fedebarrilete/stm32f103_ds18b20_modbus/eschematic.pdf

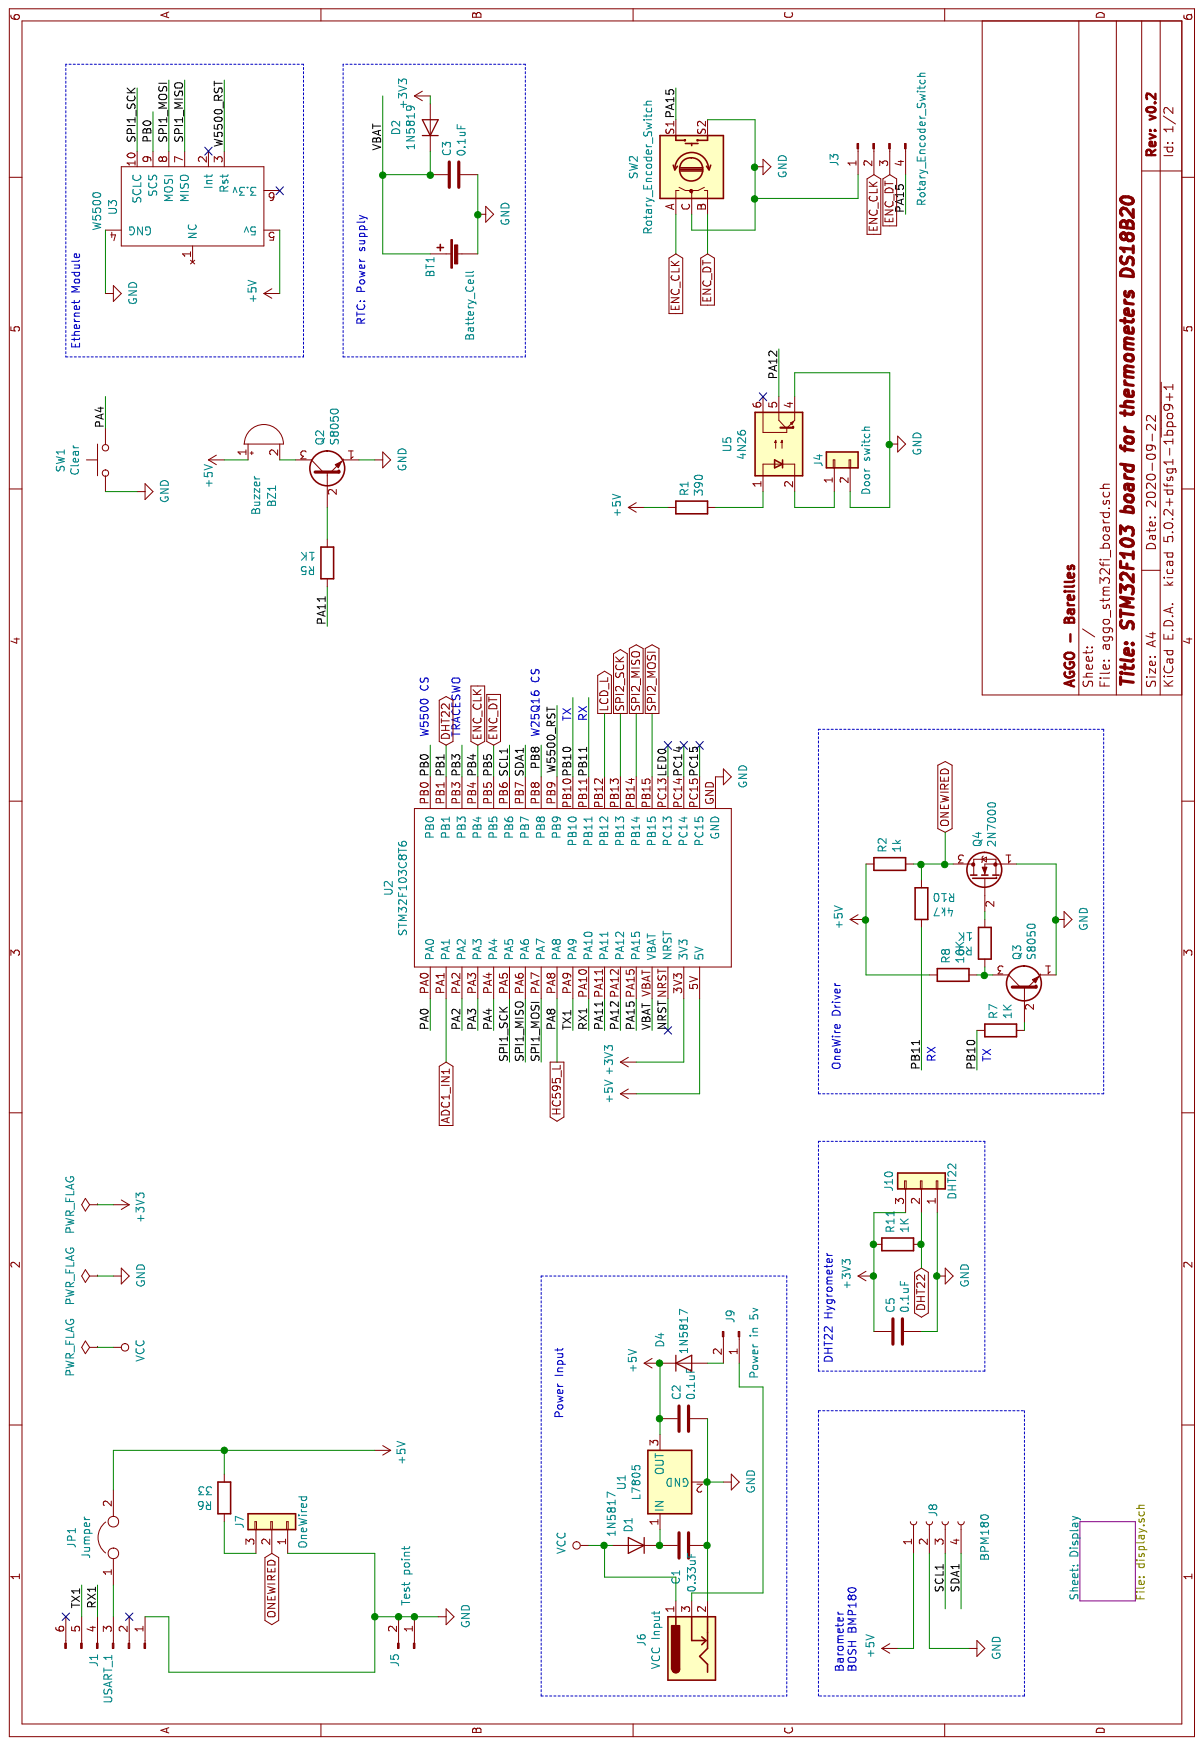
[picture p1: page 1]

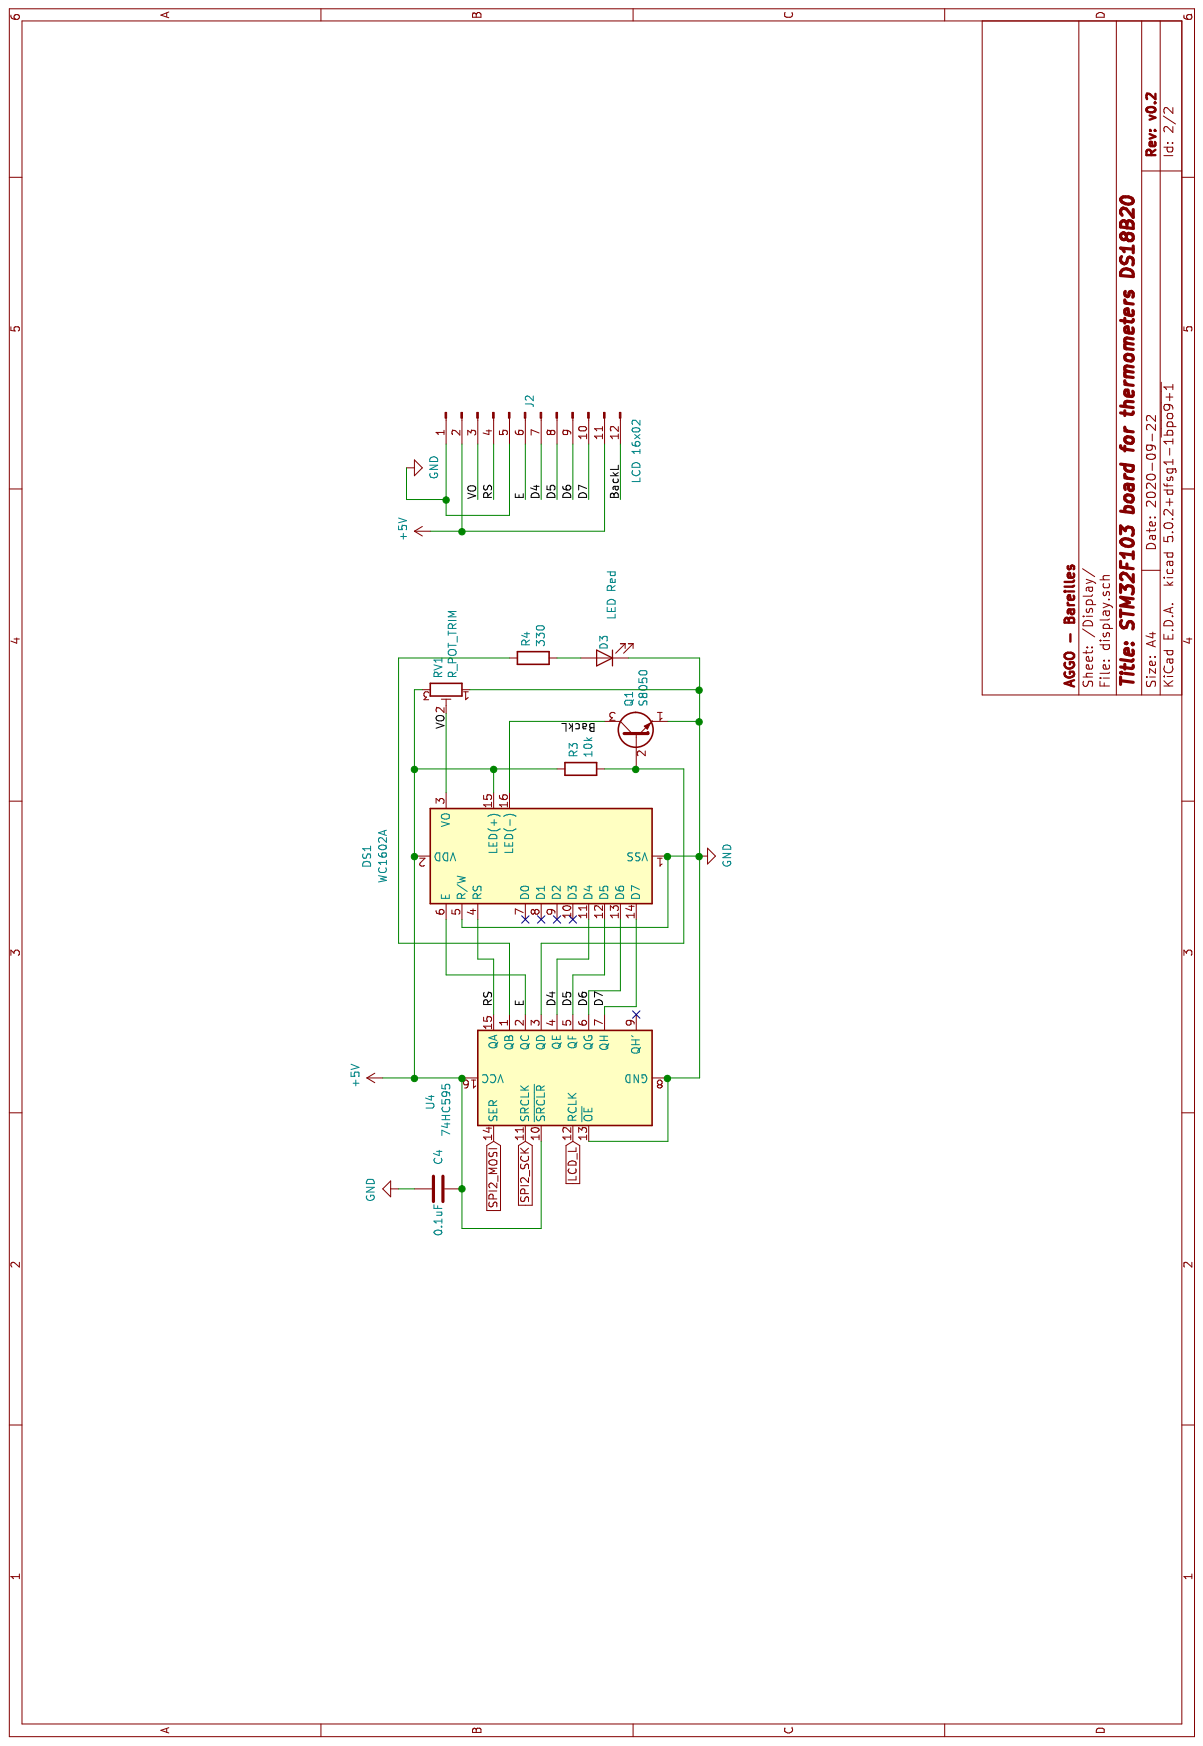
[picture p2: page 2]
