fedebarrilete/stm32f103_ds18b20_modbus/Inc/main.h

#define LED0_Pin GPIO_PIN_13
#define LED0_GPIO_Port GPIOC
#define Clear_Pin GPIO_PIN_4
#define Clear_GPIO_Port GPIOA
#define W5500_CS_Pin GPIO_PIN_0
#define W5500_CS_GPIO_Port GPIOB
#define DHT22_Pin GPIO_PIN_1
#define DHT22_GPIO_Port GPIOB
#define DHT22_EXTI_IRQn EXTI1_IRQn
#define Boot1_Pin GPIO_PIN_2
#define Boot1_GPIO_Port GPIOB
#define LCD_LATCH_Pin GPIO_PIN_12
#define LCD_LATCH_GPIO_Port GPIOB
#define HC595_LATCH_Pin GPIO_PIN_8
#define HC595_LATCH_GPIO_Port GPIOA
#define BUZZER_Pin GPIO_PIN_11
#define BUZZER_GPIO_Port GPIOA
#define DOOR_SW_Pin GPIO_PIN_12
#define DOOR_SW_GPIO_Port GPIOA
#define ENC_SW_Pin GPIO_PIN_15
#define ENC_SW_GPIO_Port GPIOA
#define ENC_SW_EXTI_IRQn EXTI15_10_IRQn
#define DBG_Pin GPIO_PIN_3
#define DBG_GPIO_Port GPIOB
#define W25Q16_CS_Pin GPIO_PIN_8
#define W25Q16_CS_GPIO_Port GPIOB
#define W5500_RST_Pin GPIO_PIN_9
#define W5500_RST_GPIO_Port GPIOB
