fedebarrilete/stm32f103_ds18b20_modbus/Src/my_rtc_time.c

/** 
 *   @file my_rct_tima.c
 *   @brief presistent RTC and Unix time implementtion.
 *   @author Bareilles Federico fede@fcaglp.unlp.edu.ar>
 *   @date 26/01/2020
 * 
 *   @copyright (c) Copyright 2020 Federico Bareilles <fede@fcaglp.unlp.edu.ar>.
 *
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
 *   The author does NOT admit liability nor provide warranty for any
 *   of this software. This material is provided "AS-IS" in the hope
 *   that it may be useful for others.
 *
 *   01/02/2020: Created.
 **/

/*
  Circuit: 
http://embedded-lab.com/blog/stm32s-internal-rtc/
*/

#include <string.h>

#include "my_rtc_time.h"
#include "SNTP/sntp.h"

/* date --date="2020-01-01 00:00:00" -u +%s */
#define UNIX_T_OFFSET 1577836800U


#if MY_CFG_RTC_ENABLE

static RTC_HandleTypeDef *hrtc = NULL;



/**
  * @brief  Enters the RTC Initialization mode.
  * @param  hrtc   pointer to a RTC_HandleTypeDef structure that contains
  *                the configuration information for RTC.
  * @retval HAL status
  */
static HAL_StatusTypeDef RTC_EnterInitMode(RTC_HandleTypeDef *hrtc)
{
  uint32_t tickstart = 0U;

  tickstart = HAL_GetTick();
  /* Wait till RTC is in INIT state and if Time out is reached exit */
  while ((hrtc->Instance->CRL & RTC_CRL_RTOFF) == (uint32_t)RESET)
  {
    if ((HAL_GetTick() - tickstart) >  RTC_TIMEOUT_VALUE)
    {
      return HAL_TIMEOUT;
    }
  }

  /* Disable the write protection for RTC registers */
  __HAL_RTC_WRITEPROTECTION_DISABLE(hrtc);


  return HAL_OK;
}

/**
  * @brief  Exit the RTC Initialization mode.
  * @param  hrtc   pointer to a RTC_HandleTypeDef structure that contains
  *                the configuration information for RTC.
  * @retval HAL status
  */
static HAL_StatusTypeDef RTC_ExitInitMode(RTC_HandleTypeDef *hrtc)
{
  uint32_t tickstart = 0U;

  /* Disable the write protection for RTC registers */
  __HAL_RTC_WRITEPROTECTION_ENABLE(hrtc);

  tickstart = HAL_GetTick();
  /* Wait till RTC is in INIT state and if Time out is reached exit */
  while ((hrtc->Instance->CRL & RTC_CRL_RTOFF) == (uint32_t)RESET)
  {
    if ((HAL_GetTick() - tickstart) >  RTC_TIMEOUT_VALUE)
    {
      return HAL_TIMEOUT;
    }
  }

  return HAL_OK;
}



/**
  * @brief  Write the time counter in RTC_CNT registers.
  * @param  hrtc   pointer to a RTC_HandleTypeDef structure that contains
  *                the configuration information for RTC.
  * @param  TimeCounter: Counter to write in RTC_CNT registers
  * @retval HAL status
  */
static HAL_StatusTypeDef RTC_WriteTimeCounter(RTC_HandleTypeDef *hrtc, uint32_t TimeCounter)
{
  HAL_StatusTypeDef status = HAL_OK;

  /* Set Initialization mode */
  if (RTC_EnterInitMode(hrtc) != HAL_OK)
  {
    status = HAL_ERROR;
  }
  else
  {
    /* Set RTC COUNTER MSB word */
    WRITE_REG(hrtc->Instance->CNTH, (TimeCounter >> 16U));
    /* Set RTC COUNTER LSB word */
    WRITE_REG(hrtc->Instance->CNTL, (TimeCounter & RTC_CNTL_RTC_CNT));

    /* Wait for synchro */
    if (RTC_ExitInitMode(hrtc) != HAL_OK)
    {
      status = HAL_ERROR;
    }
  }

  return status;
}

/**
  * @brief  Read the time counter available in RTC_CNT registers.
  * @param  hrtc   pointer to a RTC_HandleTypeDef structure that contains
  *                the configuration information for RTC.
  * @retval Time counter
  */
static uint32_t RTC_ReadTimeCounter(RTC_HandleTypeDef *hrtc)
{
  uint16_t high1 = 0U, high2 = 0U, low = 0U;
  uint32_t timecounter = 0U;

  high1 = READ_REG(hrtc->Instance->CNTH & RTC_CNTH_RTC_CNT);
  low   = READ_REG(hrtc->Instance->CNTL & RTC_CNTL_RTC_CNT);
  high2 = READ_REG(hrtc->Instance->CNTH & RTC_CNTH_RTC_CNT);

  if (high1 != high2)
  {
    /* In this case the counter roll over during reading of CNTL and CNTH registers,
       read again CNTL register then return the counter value */
    timecounter = (((uint32_t) high2 << 16U) | READ_REG(hrtc->Instance->CNTL & RTC_CNTL_RTC_CNT));
  }
  else
  {
    /* No counter roll over during reading of CNTL and CNTH registers, counter
       value is equal to first value of CNTL and CNTH */
    timecounter = (((uint32_t) high1 << 16U) | low);
  }

  return timecounter;
}


uint32_t my_time(uint32_t *tloc)
{
	uint32_t cnt = RTC_ReadTimeCounter(hrtc);

	cnt += UNIX_T_OFFSET;
	cnt += get_seconds_from_time_zone();
	//if ( tloc != NULL )
	//	*tloc = cnt;
	
	return cnt;
}

int my_HAL_Set_Unix_Time(RTC_HandleTypeDef *hrtc, uint32_t time)
{
	time -= UNIX_T_OFFSET;
	time -= get_seconds_from_time_zone();
	RTC_WriteTimeCounter(hrtc, time);
	
	return 0;
}


int my_RTC_Init(RTC_HandleTypeDef *hal_rtc)
{
	hrtc = hal_rtc;

	return 0;
}

#else

uint32_t _time_offset_uptime = 0;

#endif /* MY_CFG_RTC_ENABLE */
