fedebarrilete/stm32f103_ds18b20_modbus/Inc/eepromConf.h

#ifndef __EEPROMCONFIG_H
#define __EEPROMCONFIG_H

#define   _EEPROM_STORE_BEFOR_ERASE___NEED_MORE_RAM     (1)

#define   _EEPROM_F030x4_F030x6_F070x6_F030x8           (0)
#define   _EEPROM_F1_LOW_DESTINY                        (0)
#define   _EEPROM_F1_MEDIUM_DESTINY                     (1)
#define   _EEPROM_F1_HIGH_DESTINY                       (0)

#define   _EEPROM_USE_FLASH_PAGE                       (63)

#endif
