fedebarrilete/stm32f103_ds18b20_modbus/Src/iwdg.c

/**
  ******************************************************************************
  * File Name          : IWDG.c
  * Description        : This file provides code for the configuration
  *                      of the IWDG instances.
  ******************************************************************************
  * @attention
  *
  * <h2><center>&copy; Copyright (c) 2021 STMicroelectronics.
  * All rights reserved.</center></h2>
  *
  * This software component is licensed by ST under BSD 3-Clause license,
  * the "License"; You may not use this file except in compliance with the
  * License. You may obtain a copy of the License at:
  *                        opensource.org/licenses/BSD-3-Clause
  *
  ******************************************************************************
  */

/* Includes ------------------------------------------------------------------*/
#include "iwdg.h"

/* USER CODE BEGIN 0 */

#include "my_config.h"


IWDG_HandleTypeDef hiwdg;

/**
  * @brief IWDG Initialization Function
  * @param None
  * @retval None
  */
void MX_IWDG_Init(void)
{
#if (MY_CFG_WDT_ENABLE == 0)
	return;
#endif
	hiwdg.Instance = IWDG;
	hiwdg.Init.Prescaler = IWDG_PRESCALER_32;
	hiwdg.Init.Reload = 1250;
	if (HAL_IWDG_Init(&hiwdg) != HAL_OK)
	{
		Error_Handler();
	}
}

#if 0
/* USER CODE END 0 */

IWDG_HandleTypeDef hiwdg;

/* IWDG init function */
void MX_IWDG_Init(void)
{

  hiwdg.Instance = IWDG;
  hiwdg.Init.Prescaler = IWDG_PRESCALER_32;
  hiwdg.Init.Reload = 1250;
  if (HAL_IWDG_Init(&hiwdg) != HAL_OK)
  {
    Error_Handler();
  }

}

/* USER CODE BEGIN 1 */
#endif
/* USER CODE END 1 */

/************************ (C) COPYRIGHT STMicroelectronics *****END OF FILE****/
