fedebarrilete/stm32f103_ds18b20_modbus/(commit log)

2021-06-30 I fix the closing of TCP connections
    [modbus.c]
2023-08-10 Update encoder_sw.c
    Fix bug in en_setup(): bad initialization.
    [encoder_sw.c]
