fedebarrilete/stm32f103_ds18b20_modbus/(notices)

Notices in the files:
Src/my_lcd.c:
modify it under the terms of the GNU General Public License as
published by the Free Software Foundation; either version 2 of
the License, or (at your option) any later version.
Inc/main.h:
© Copyright (c) 2020 STMicroelectronics.
All rights reserved.
